lakka-sails/slow-dance-frame/images/circut.png

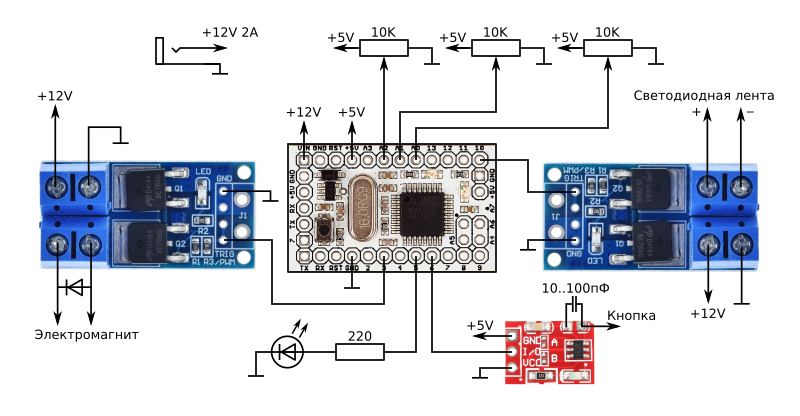
images/circut.png
